HCIELab/EIT-kit_open-source/EIT-kit-Arduino-library/MCP23S17-modified-for-eit-kit/README.md

MCP23S17
========

Arduino library for MCP23S17 IO Expanders
