HCIELab/EIT-kit_open-source/EIT-kit-Board/ESP32_EIT_V3_fusion/ESP32_EIT_back.png

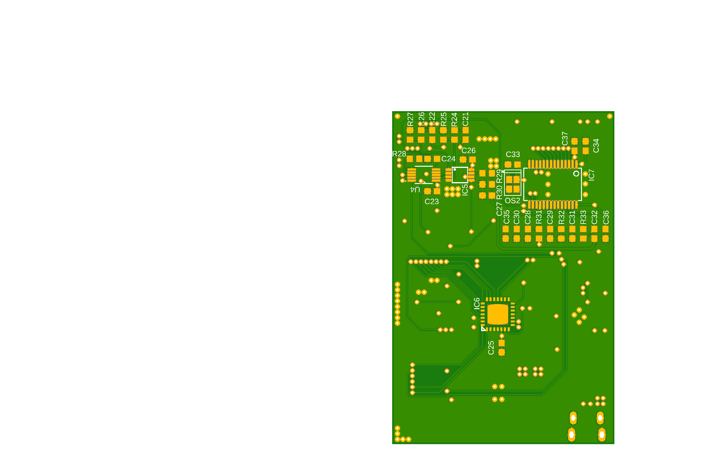
EIT-kit-Board/ESP32_EIT_V3_fusion/ESP32_EIT_back.png
