HCIELab/EIT-kit_open-source/EIT-kit-Board/ESP32_EIT_V3_fusion/ESP32_EIT_front.png

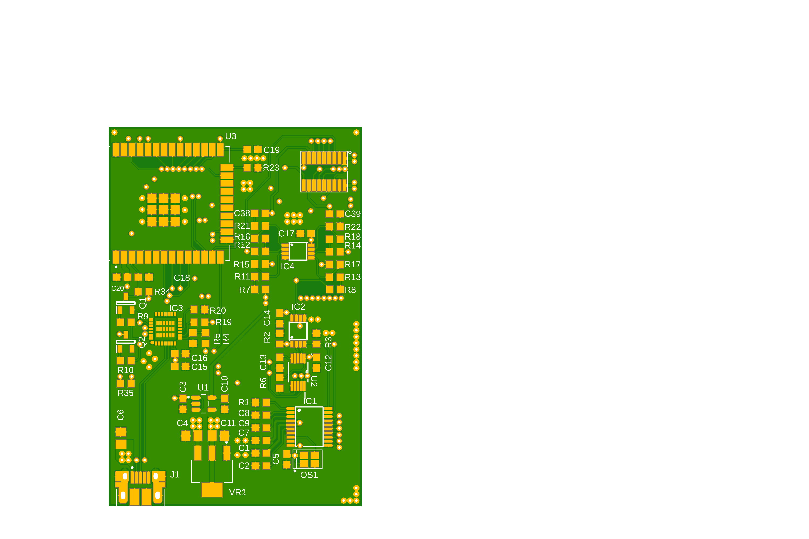
EIT-kit-Board/ESP32_EIT_V3_fusion/ESP32_EIT_front.png
