HCIELab/EIT-kit_open-source/EIT-kit-Board_new/Teensy_EIT_board-files/Main/PCB_bottom.png

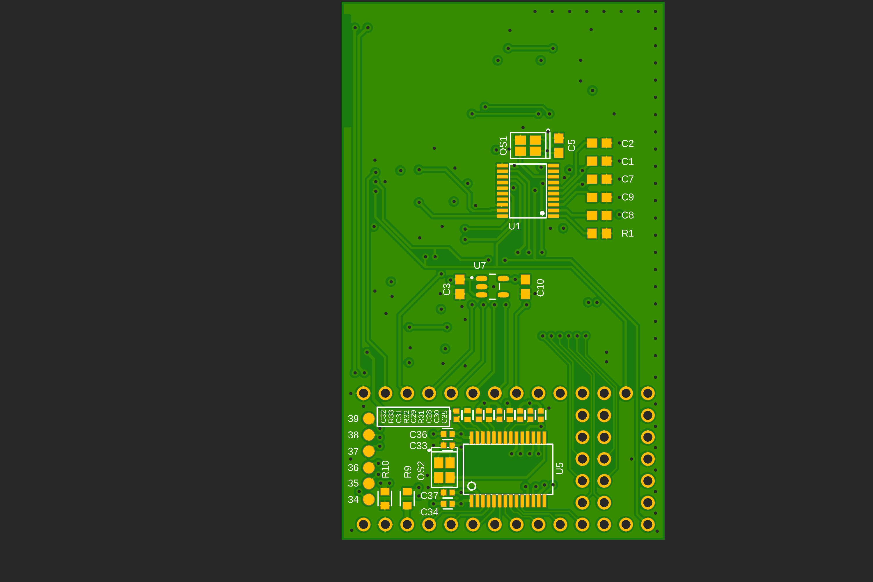
EIT-kit-Board_new/Teensy_EIT_board-files/Main/PCB_bottom.png
