HCIELab/EIT-kit_open-source/EIT-kit-Board_new/Teensy_EIT_board-files/MUX1/PCB_bottom.png

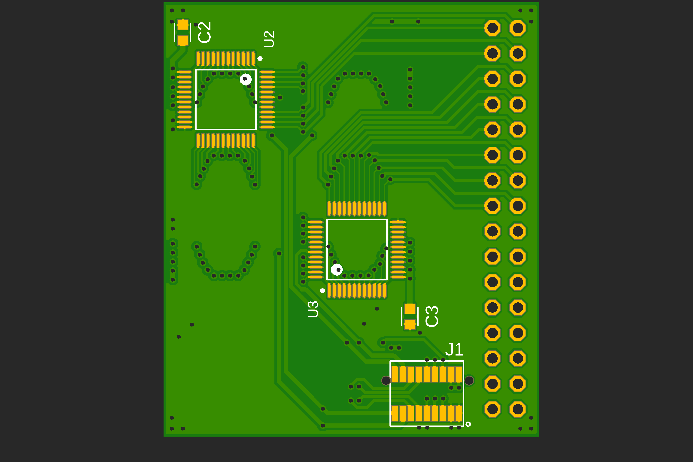
EIT-kit-Board_new/Teensy_EIT_board-files/MUX1/PCB_bottom.png
