HCIELab/EIT-kit_open-source/EIT-kit-Board_new/Teensy_EIT_board-files/MUX2/PCB_top.png

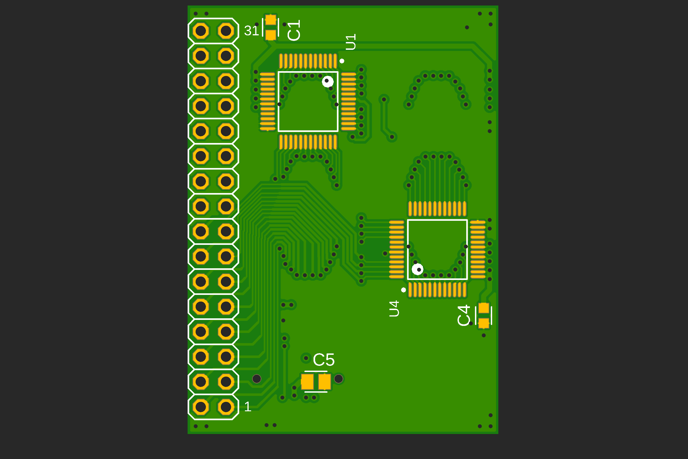
EIT-kit-Board_new/Teensy_EIT_board-files/MUX2/PCB_top.png
