HCIELab/EIT-kit_open-source/(threads)

Thread 1 (2022-05-18):

Mux board problem

MilesLeeee, 2022-05-18:
Hi ~
I would like to implement the sensing board in this paper, however ,I can not find the code of Mux board(ADG731), if possible, can I ask you for the Sorce code for this board?
thank you

MilesLeeee, 2022-05-30:
I'm an student from NCKU, our lab wants to implement an EIT device to measure the impedance changes in body muscle during exercise, so I want to try to implement this board and I hope to get your help if possible.
Sincerely,
MilesLeee

MilesLeeee, 2022-06-03:
Hello
I have a question about mux board and want to ask. There are two boards mux1 and mux2 in the file (the two boards seem to be different), we want to know whether the mux board mentioned in the paper uses mux1 or mux2? Is there a circuit or a BOM that we can refer to?thank you~
Sincerely,
MilesLeee

junyi7, 2022-06-06:
Hi MilesLeee,
The mux1 & mux2 are equivalent and can work individually or together, depends on how many electrodes you need for you application. Each mux board can support 32 electrodes. The BOM files for mux1 & mux2 are now in the git repo, they pretty much use the same components.
Let me know your email address if you want to try out the newer version, I can email the files to you :)
Best,
Junyi

MilesLeeee, 2022-08-10:
Hi Junyi~
I have some questions about the mux board, can you help me,thank you.
When we were doing it, we found that the part number in the MUX1_gerber file doesn't seem to match the part number in the Bom file (bom_mux_lower), can you help me see if there is something wrong?thank you
Here is my mail address : N26101800@gs.ncku.edu.tw, I hope I can contact you if I have other questions :)
Sincerely,
MilesLeee

Thread 6 (2023-01-11):

Cannot open Teensy board files in EAGLE

roy-zahor, 2023-01-11:
Hi,

New verison files in [EIT-kit-Board_new](https://github.com/HCIELab/EIT-kit_open-source/tree/main/EIT-kit-Board_new)
cannot be open in eagle. Both schematic and PCB files give warnings and files are partially opened. I can open the ESP32 files without a problem.

1. Is the Teensy version stable in terms of hardware & software or do you recommend using the ESP32 version?
2. Can you please check the files?

Many thanks,
Roy

junyi7, 2024-02-25:
Hi Roy,

Sorry for the confusion! Please try using Fusion 360 to open the new files rather than EAGLE, we switched the new files to Fusion 360 because EAGLE is discontinued and no longer supported by Autodesk, and they promotes everything to Fusion 360 instead. And yes, the Teensy version is more stable in terms of the hardware (more stable GPIO pin readings at high speed).

Best,
Junyi

Closed 2024-02-25.

Thread 7 (2025-07-29):

Help with building the board

emmapead, 2025-07-29:
Hello,

Thank you for sharing your fantastic work! I am a researcher in data science looking to use EIT for a project. I don't have the access to the expertise to develop the board myself and was looking into PCBway to assemble for me. I need some help with which files to send them.

Could you please advise?

Thank you :)
