HCIELab/EIT-kit_open-source/EIT-kit-Board_new/Teensy_EIT_board-files/Main/Schematic.pdf

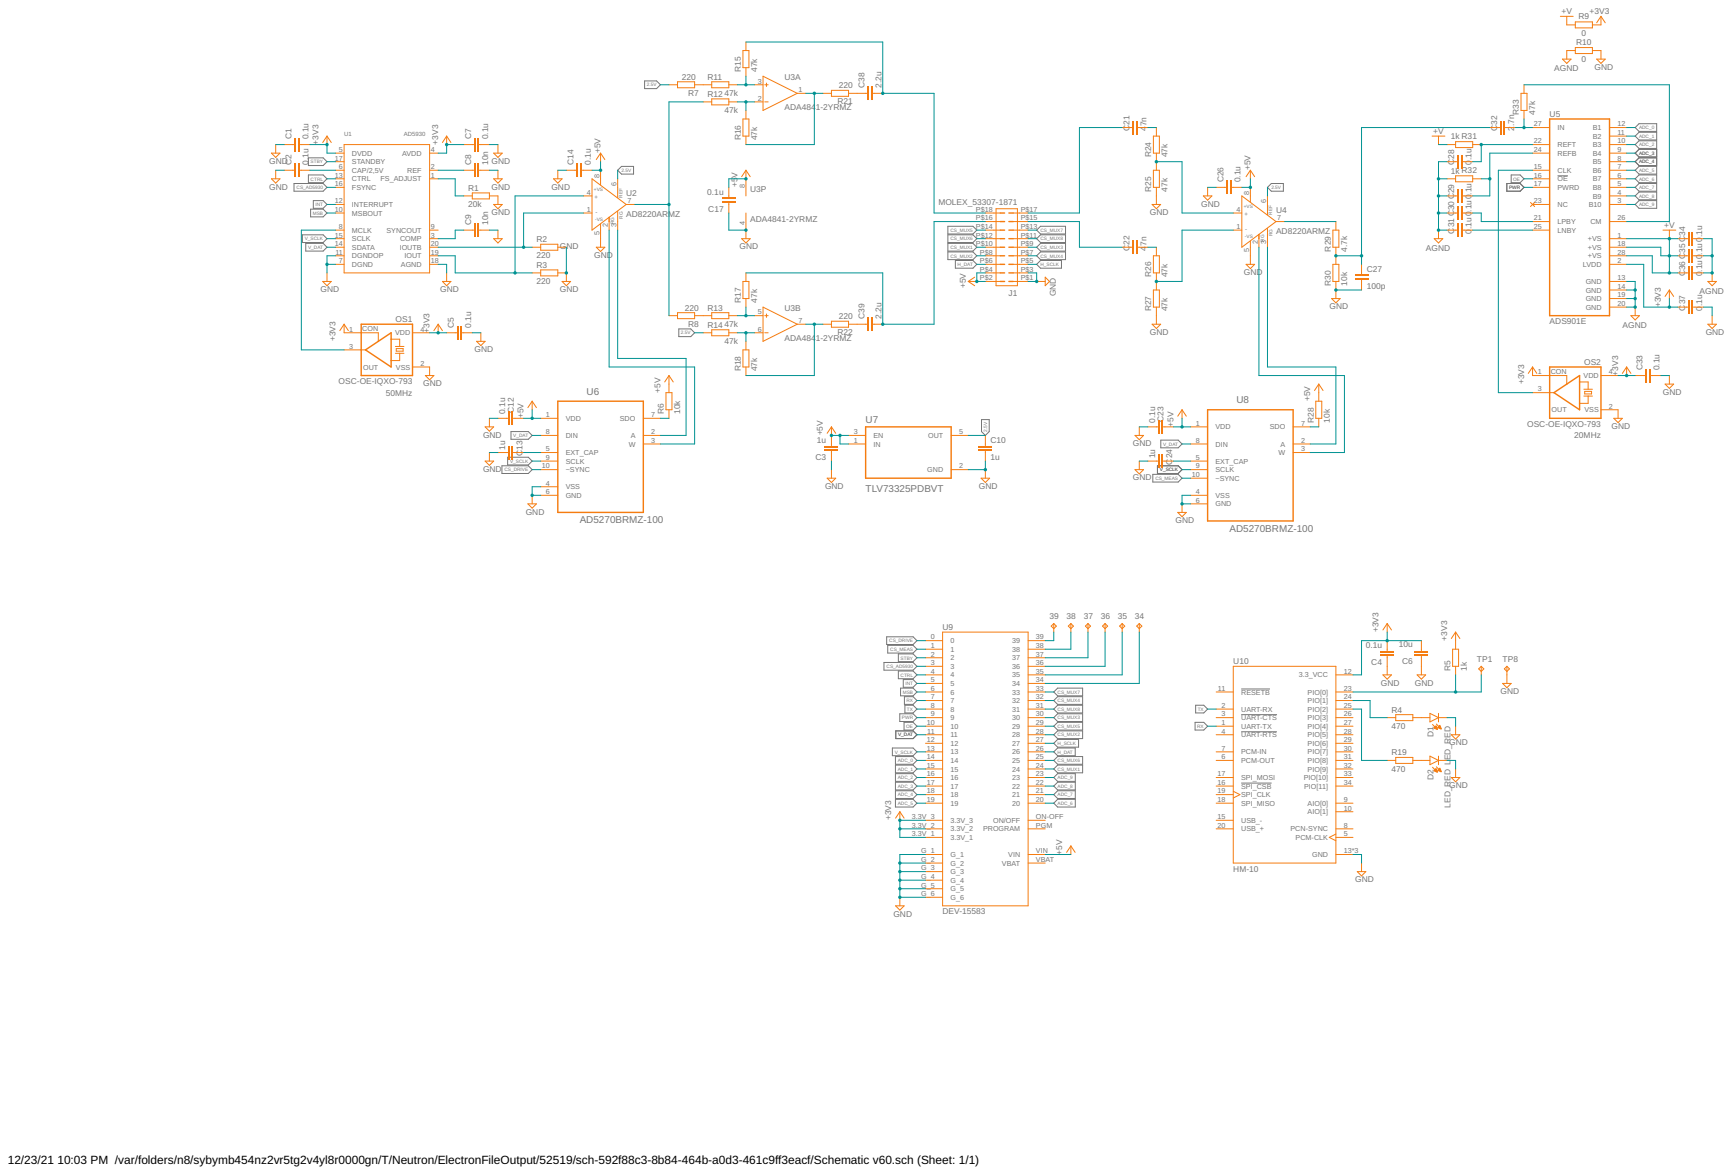
[picture p9: page 1]

12/23/21 10:03 PM /var/folders/n8/sybymb454nz2vr5tg2v4yl8r0000gn/T/Neutron/ElectronFileOutput/52519/sch-592f88c3-8b84-464b-a0d3-461c9ff3eacf/Schematic v60.sch (Sheet: 1/1)
