HCIELab/EIT-kit_open-source/EIT-kit-Board_new/Teensy_EIT_board-files/MUX1/Schematic.pdf

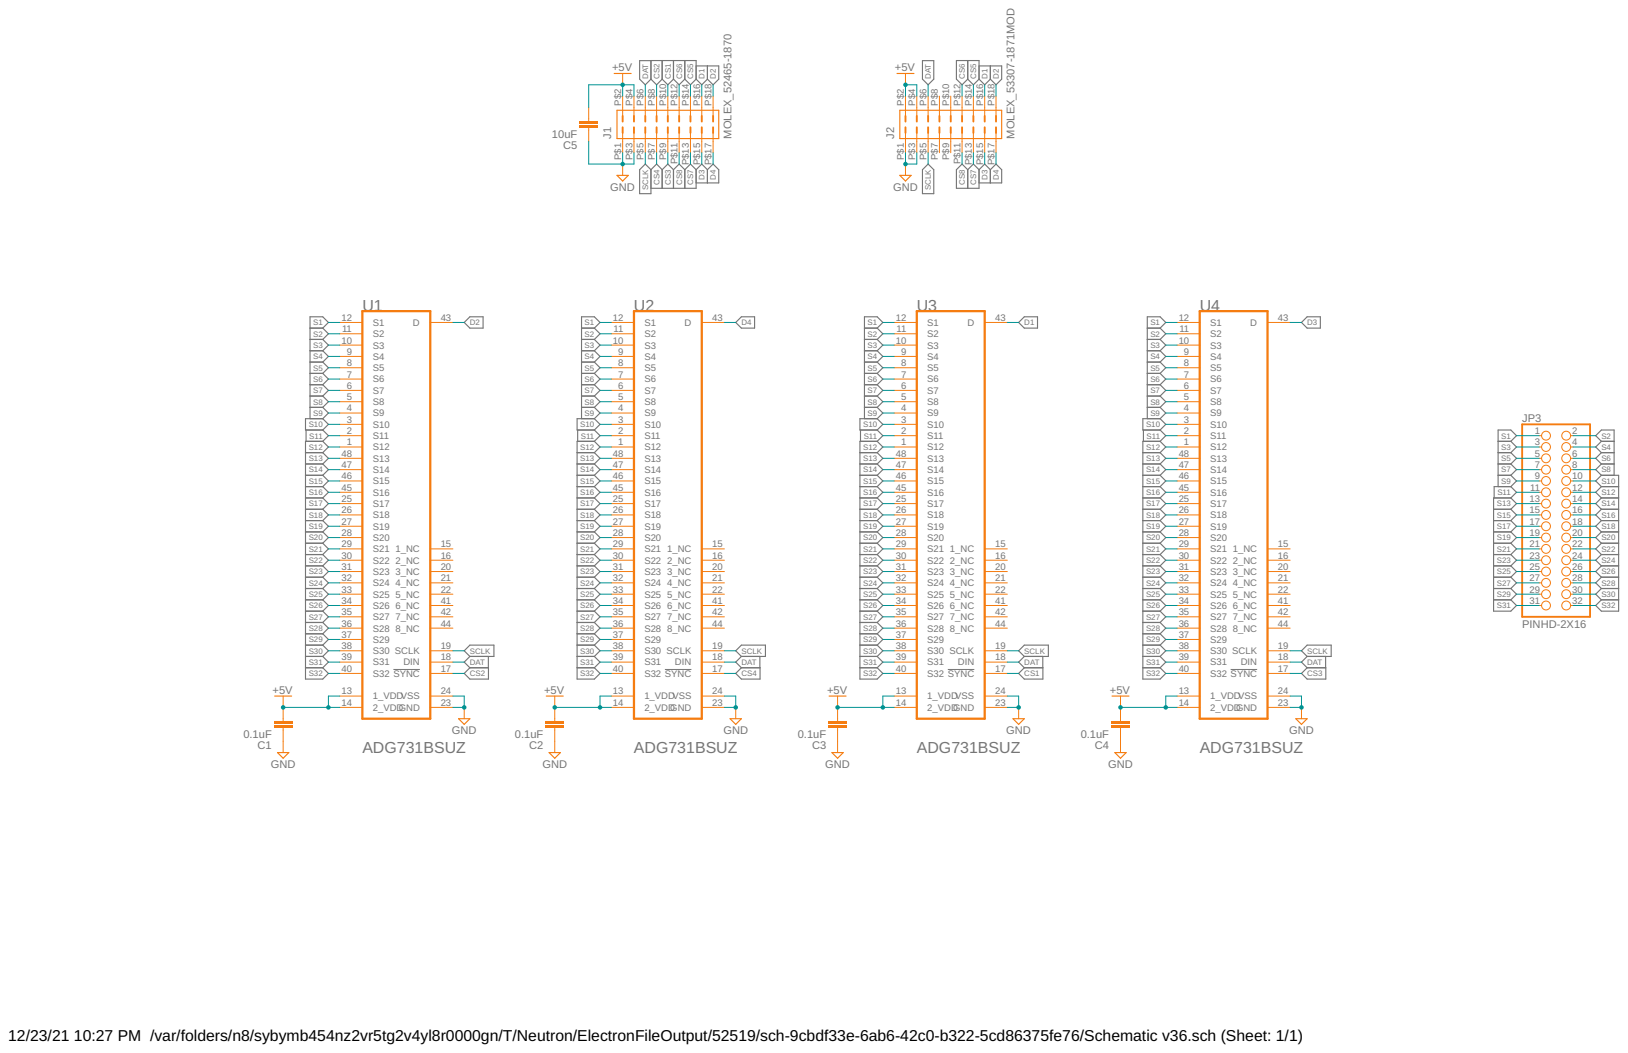
[picture p10: page 1]

12/23/21 10:27 PM /var/folders/n8/sybymb454nz2vr5tg2v4yl8r0000gn/T/Neutron/ElectronFileOutput/52519/sch-9cbdf33e-6ab6-42c0-b322-5cd86375fe76/Schematic v36.sch (Sheet: 1/1)
