HCIELab/EIT-kit_open-source/EIT-kit-Board_new/Teensy_EIT_board-files/MUX2/Schematic.pdf

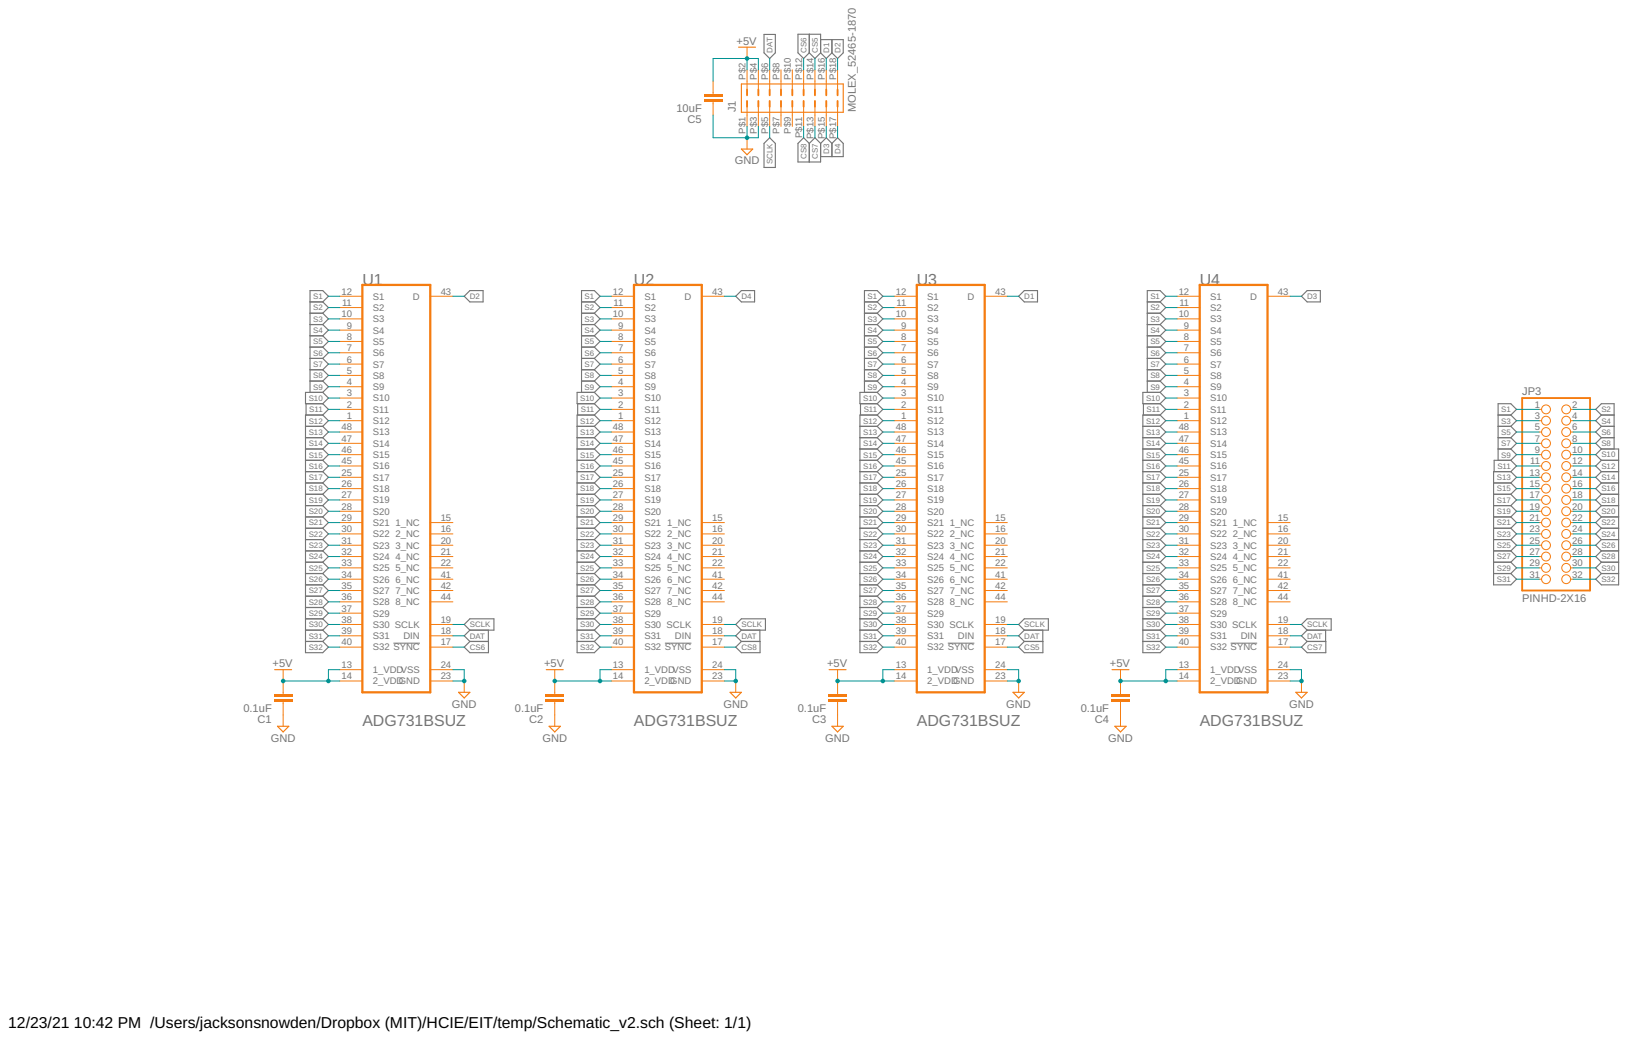
[picture p11: page 1]

12/23/21 10:42 PM /Users/jacksonsnowden/Dropbox (MIT)/HCIE/EIT/temp/Schematic_v2.sch (Sheet: 1/1)
