HCIELab/EIT-kit_open-source/EIT-kit-Board/ESP32_EIT_V3_fusion/Schematic/ESP32_EIT.pdf

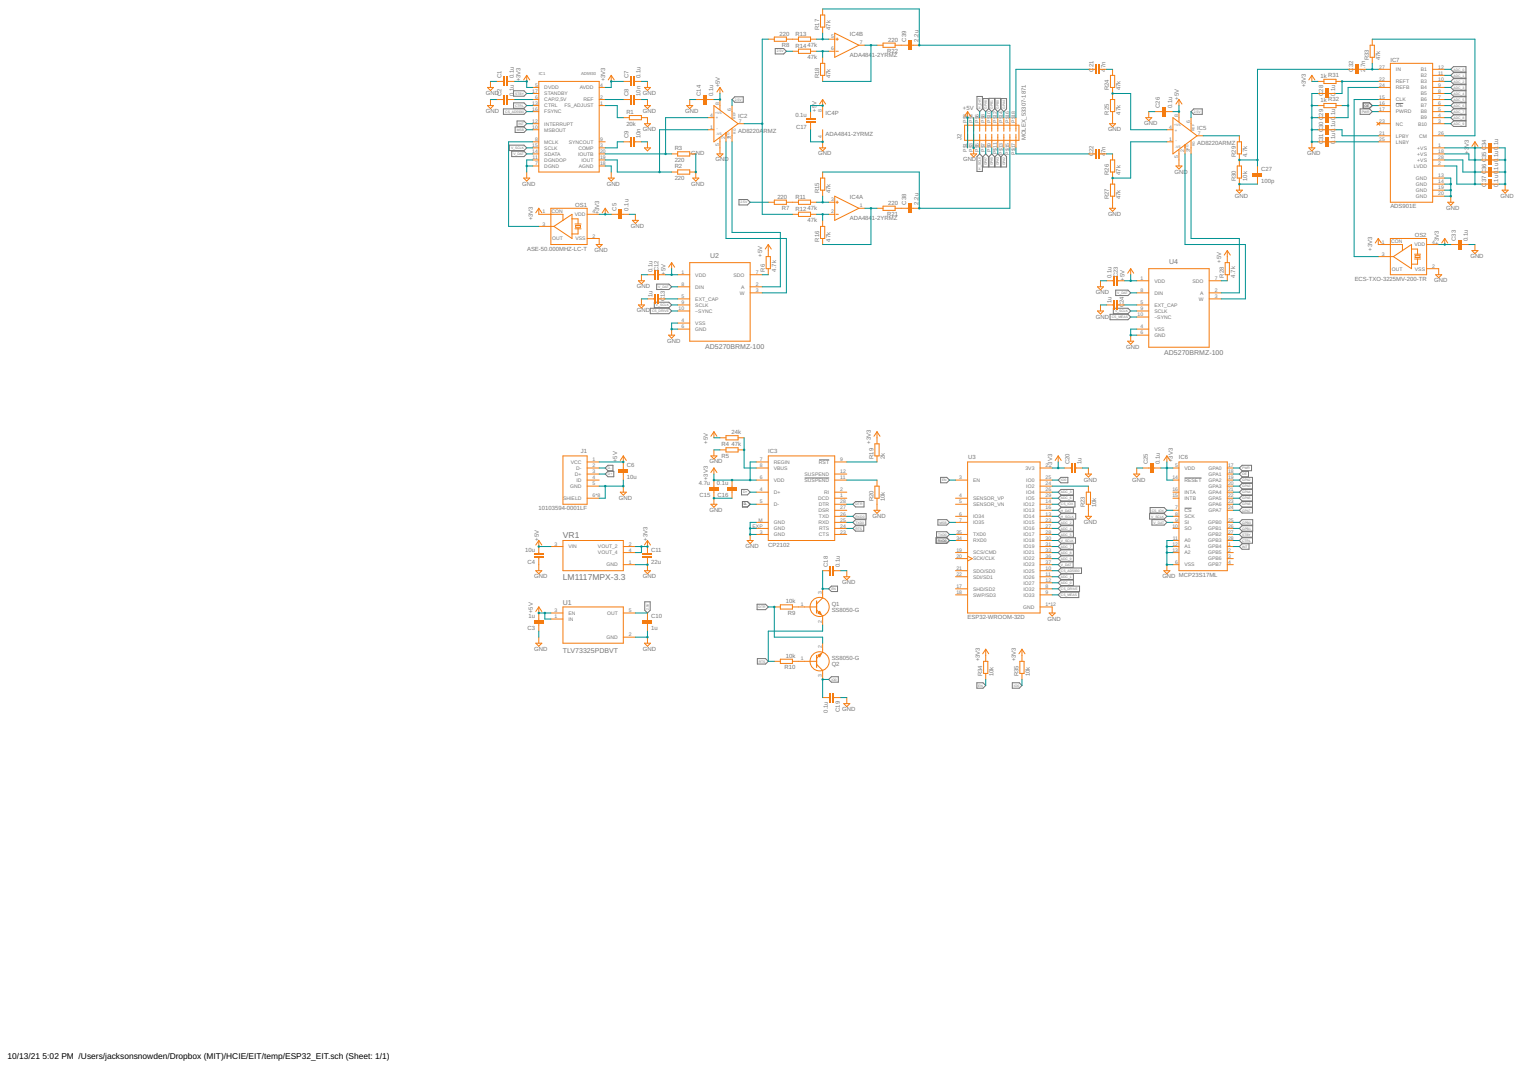
[picture p12: page 1]

10/13/21 5:02 PM /Users/jacksonsnowden/Dropbox (MIT)/HCIE/EIT/temp/ESP32_EIT.sch (Sheet: 1/1)
