HCIELab/EIT-kit_open-source/EIT-kit-Board/ESP32_EIT_V3_EAGLE/ESP32_EIT_V3.brd

## EAGLE design EIT-kit-Board/ESP32_EIT_V3_EAGLE/ESP32_EIT_V3.brd (2021-10-15)

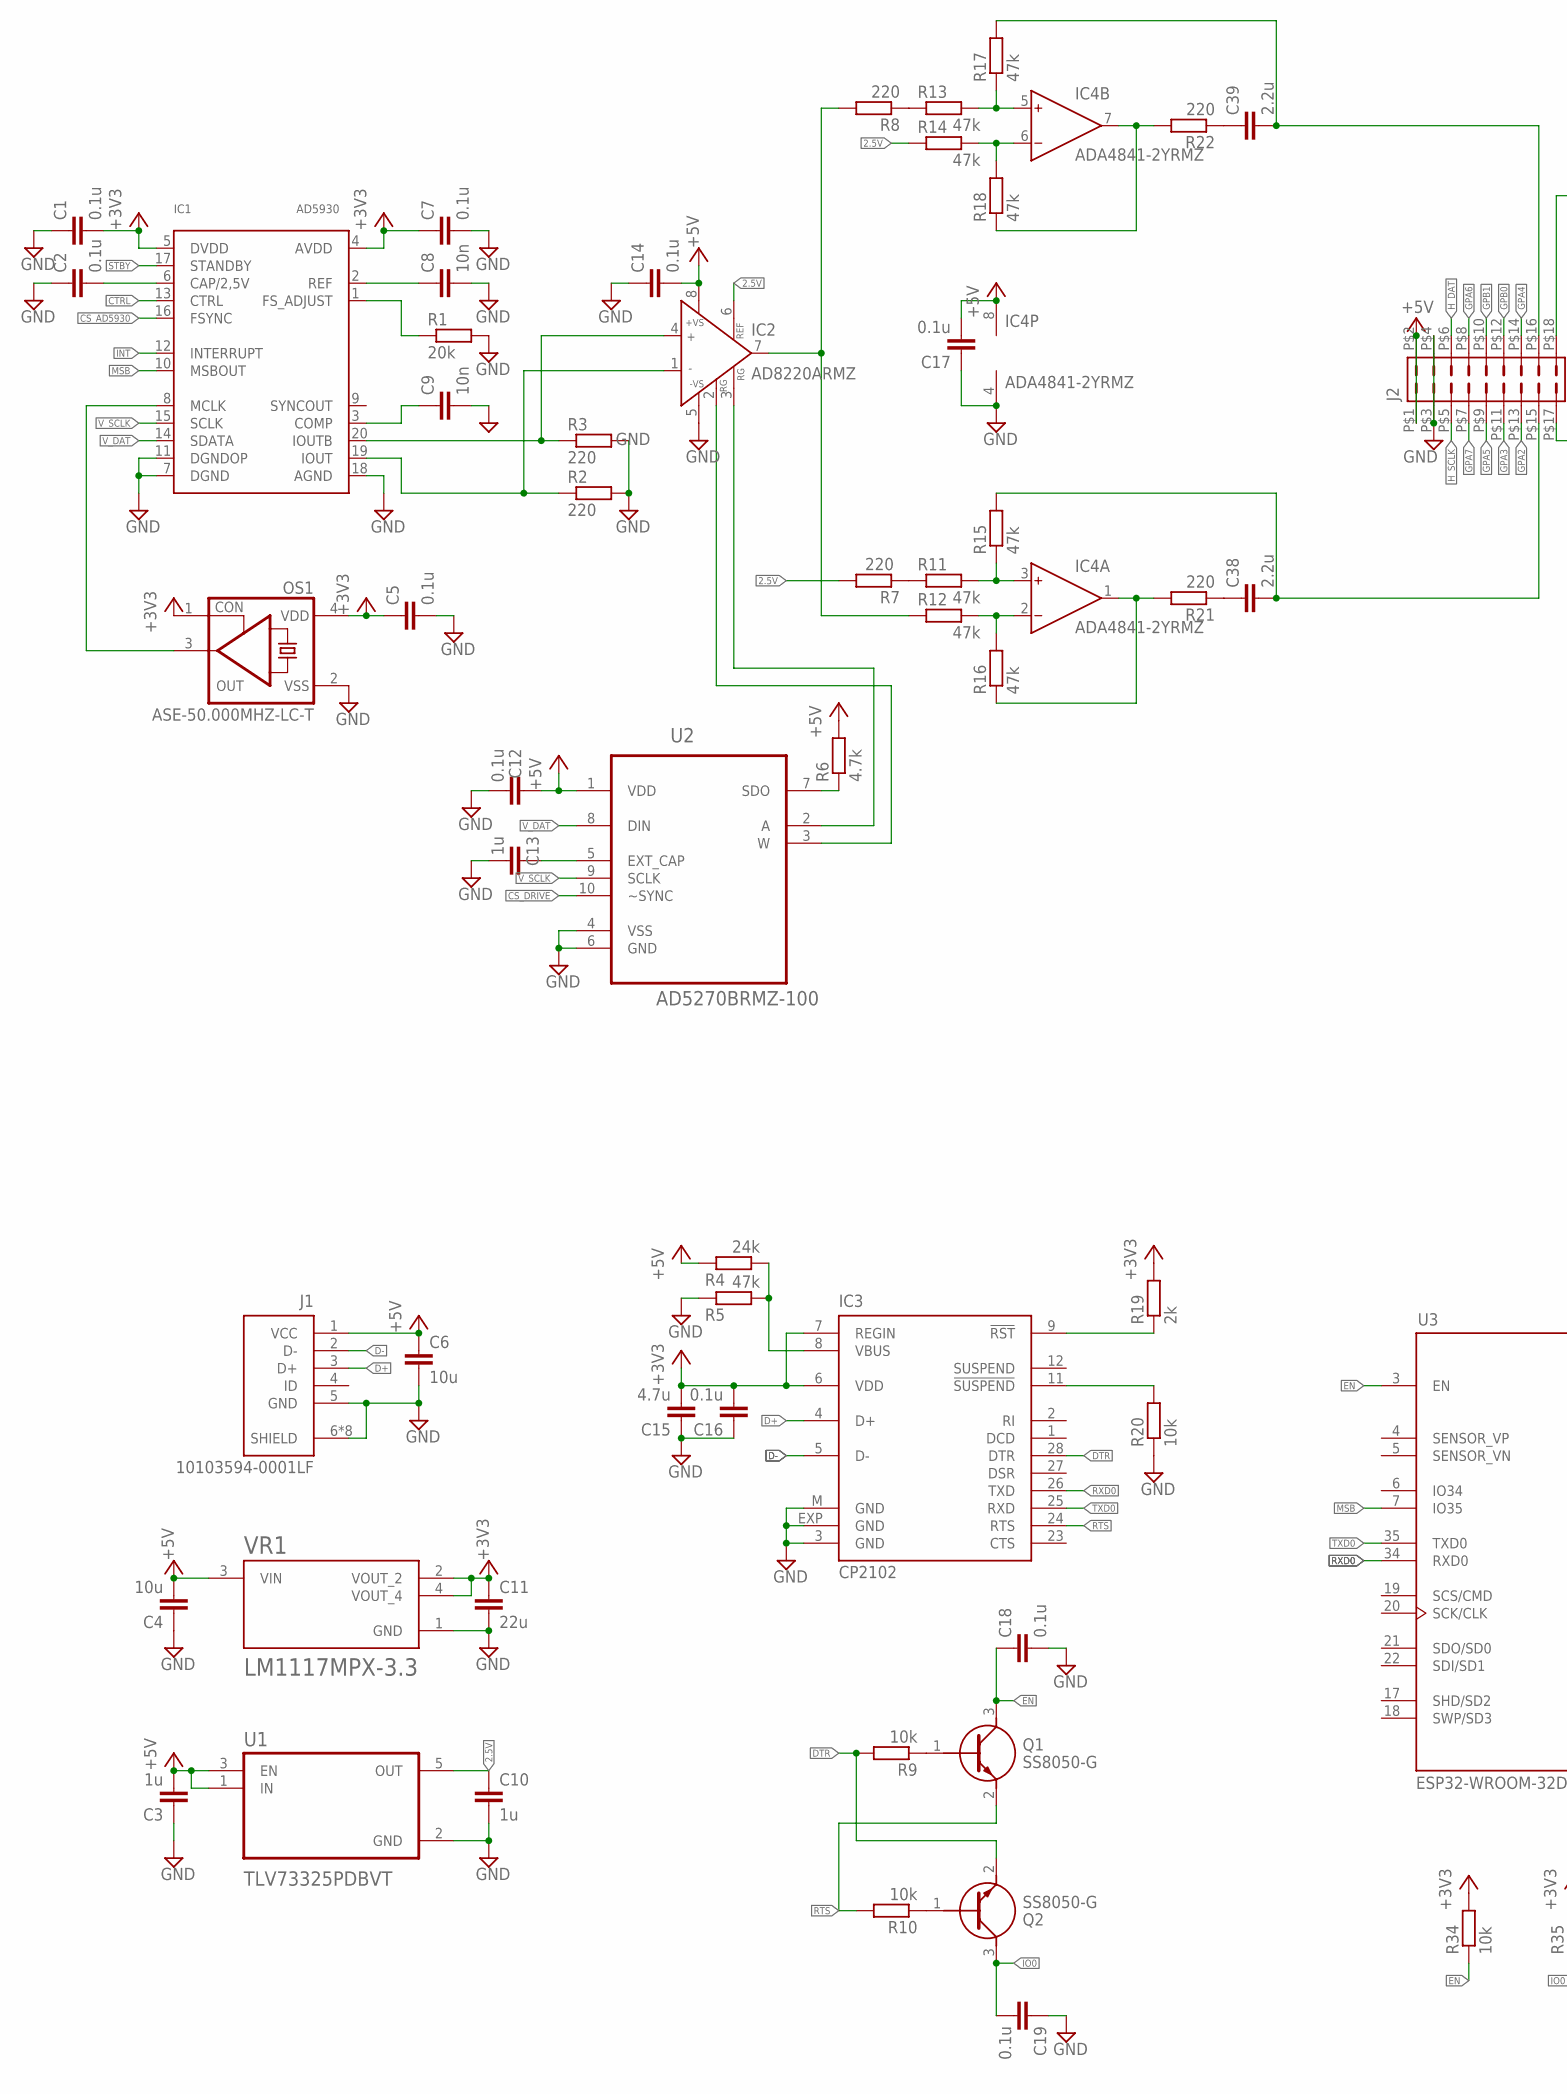
[picture p13: schematic ESP32_EIT_V3.sch, part in row 1, column 1]

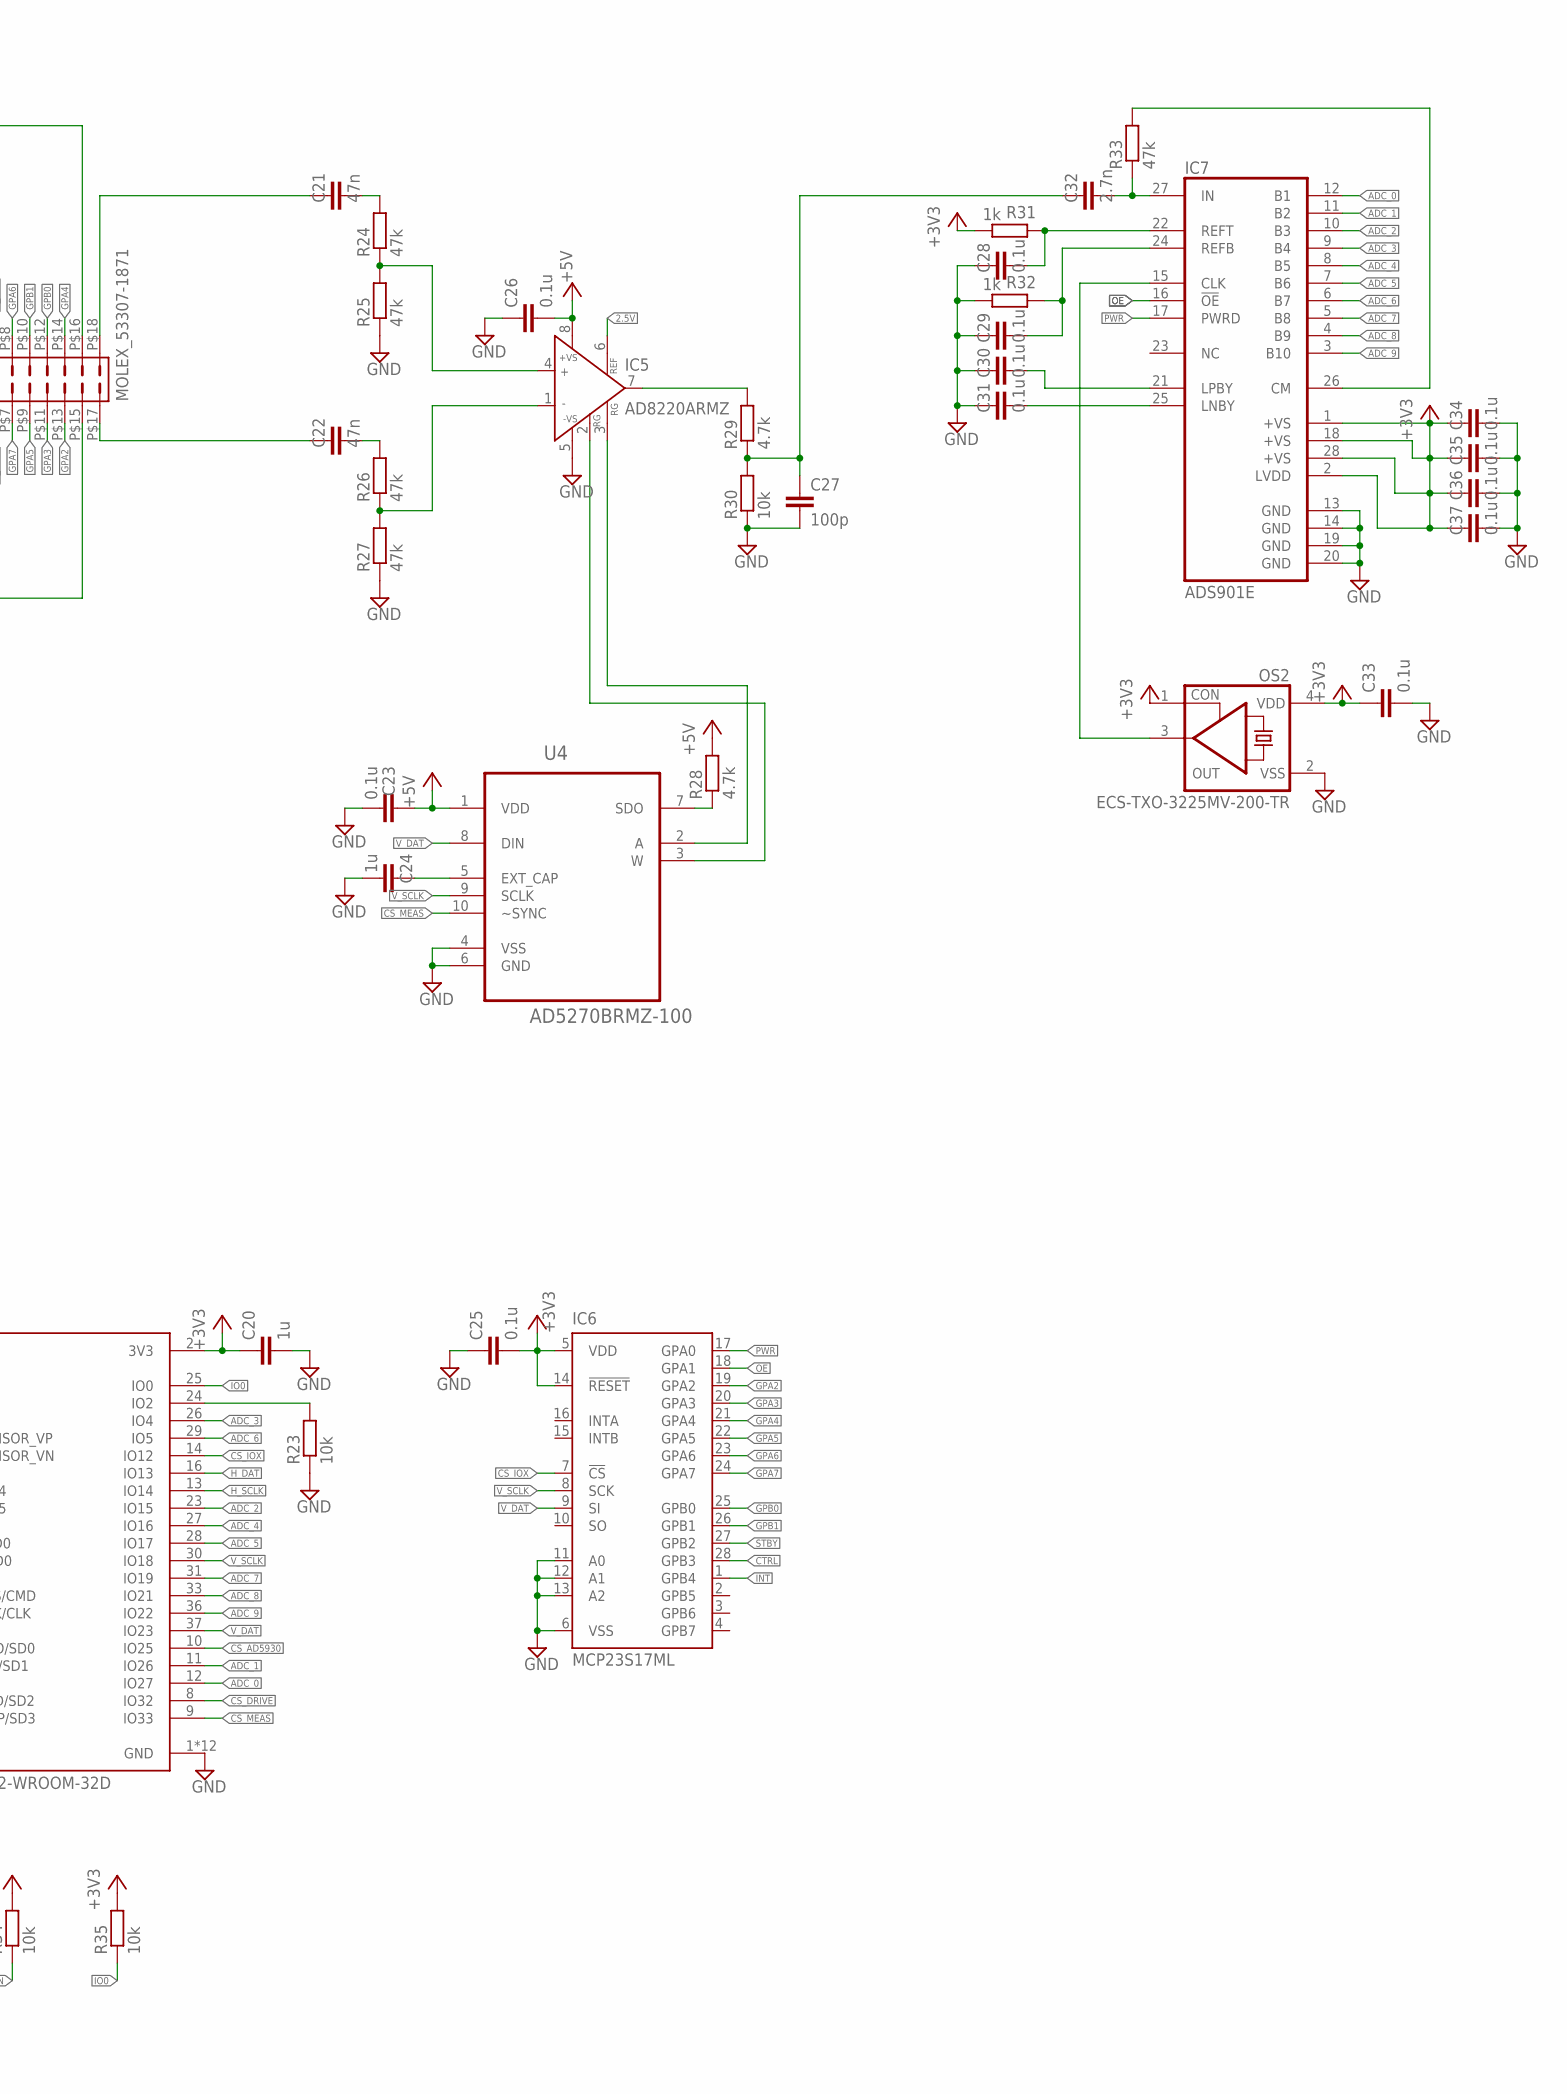
[picture p14: schematic ESP32_EIT_V3.sch, part in row 1, column 2]

Parts:
C1, C2, C5, C7, C12, C14, C16, C17, C18, C19, C23, C25, C26, C28, C29, C30, C31, C33, C34, C35, C36, C37: 0.1u; C0603
C3, C10, C13, C20, C24: 1u; C0603
C4, C6: 10u; C0805
C8, C9: 10n; C0603
C11: 22u; C0805
C15: 4.7u; C0603
C21, C22: 47n; C0603
C27: 100p; C0603
C32: 2.7n; C0603
C38, C39: 2.2u; C0603
IC1: AD5930; TSSOP20
IC2, IC5: AD8220ARMZ; MSOP8
IC3: CP2102; MLP28
IC4: ADA4841-2YRMZ; MSOP8
IC6: MCP23S17ML; QFN28-ML_6X6MM
IC7: ADS901E; SSOP28BU
J1: 10103594-0001LF; AMPHENOL_10103594-0001LF
J2: MOLEX_53307-1871
OS1: ASE-50.000MHZ-LC-T; 2.5X2-4-PAD
OS2: ECS-TXO-3225MV-200-TR; 2.5X2-4-PAD
Q1, Q2: SS8050-G; SOT95P240X115-3N
R1: 20k; R0603
R2, R3, R7, R8, R21, R22: 220; R0603
R4: 24k; R0603
R5, R11, R12, R13, R14, R15, R16, R17, R18, R24, R25, R26, R27, R33: 47k; R0603
R6, R28, R29: 4.7k; R0603
R9, R10, R20, R23, R30, R34, R35: 10k; R0603
R19: 2k; R0603
R31, R32: 1k; R0603
U1: TLV73325PDBVT; SOT95P280X145-5N
U2, U4: AD5270BRMZ-100; SOP50P490X110-10N
U3: ESP32-WROOM-32D; MODULE_ESP32-WROOM-32D
VR1: LM1117MPX-3.3; VREG_LM1117MPX-3.3

Connections:
2.5V: C10.1, IC2.6 (REF), IC5.6 (REF), R7.2, R14.1, U1.5 (OUT)
+3V3: C1.2, C5.1, C7.1, C11.1, C15.2, C16.2, C20.1, C25.2, C33.1, C34.1, C35.1, C36.1, C37.1, IC1.4 (AVDD), IC1.5 (DVDD), IC3.6 (VDD), IC3.7 (REGIN), IC6.5 (VDD), IC6.14 (!RESET), IC7.1 (+VS), IC7.2 (LVDD), IC7.18 (+VS), IC7.28 (+VS), OS1.1 (CON), OS1.4 (VDD), OS2.1 (CON), OS2.4 (VDD), R19.2, R31.2, R34.2, R35.2, U3.2 (3V3), VR1.2 (VOUT_2), VR1.4 (VOUT_4)
+5V: C3.2, C4.2, C6.1, C12.1, C14.2, C17.2, C23.1, C26.2, IC2.8 (+VS), IC4.8 (V+), IC5.8 (+VS), J1.1 (VCC), J2.P$1 (1), J2.P$2 (2), R4.2, R6.2, R28.2, U1.1 (IN), U1.3 (EN), U2.1 (VDD), U4.1 (VDD), VR1.3 (VIN)
ADC_0: IC7.12 (B1), U3.12 (IO27)
ADC_1: IC7.11 (B2), U3.11 (IO26)
ADC_2: IC7.10 (B3), U3.23 (IO15)
ADC_3: IC7.9 (B4), U3.26 (IO4)
ADC_4: IC7.8 (B5), U3.27 (IO16)
ADC_5: IC7.7 (B6), U3.28 (IO17)
ADC_6: IC7.6 (B7), U3.29 (IO5)
ADC_7: IC7.5 (B8), U3.31 (IO19)
ADC_8: IC7.4 (B9), U3.33 (IO21)
ADC_9: IC7.3 (B10), U3.36 (IO22)
CS_AD5930: IC1.16 (FSYNC), U3.10 (IO25)
CS_DRIVE: U2.10 (~SYNC), U3.8 (IO32)
CS_IOX: IC6.7 (!CS), U3.14 (IO12)
CS_MEAS: U3.9 (IO33), U4.10 (~SYNC)
CTRL: IC1.13 (CTRL), IC6.28 (GPB3)
D+: IC3.4 (D+), J1.3 (D+)
D-: IC3.5 (D-), J1.2 (D-)
DTR: IC3.28 (DTR), Q2.2 (E), R9.2
EN: C18.1, Q1.3 (C), R34.1, U3.3 (EN)
GND: C1.1, C2.1, C3.1, C4.1, C5.2, C6.2, C7.2, C8.2, C9.2, C10.2, C11.2, C12.2, C13.2, C14.1, C15.1, C16.1, C17.1, C18.2, C19.1, C20.2, C23.2, C24.2, C25.1, C26.1, C27.2, C28.1, C29.1, C30.1, C31.1, C33.2, C34.2, C35.2, C36.2, C37.2, IC1.7 (DGND), IC1.11 (DGNDOP), IC1.18 (AGND), IC2.5 (-VS), IC3.3 (GND), IC3.EXP (GND), IC3.M (GND), IC4.4 (V-), IC5.5 (-VS), IC6.6 (VSS), IC6.11 (A0), IC6.12 (A1), IC6.13 (A2), IC7.13 (GND), IC7.14 (GND), IC7.19 (GND), IC7.20 (GND), J1.5 (GND), J1.6 (SHIELD), J1.7 (SHIELD), J1.8 (SHIELD), J1.9 (SHIELD), J1.10 (SHIELD), J1.11 (SHIELD), J1.S1 (SHIELD), J1.S2 (SHIELD), J2.P$3 (3), J2.P$4 (4), OS1.2 (VSS), OS2.2 (VSS), R1.2, R2.2, R3.2, R5.2, R20.1, R23.1, R25.1, R27.1, R30.1, R32.2, U1.2 (GND), U2.4 (VSS), U2.6 (GND), U3.1 (GND), U3.15 (GND), U3.38 (GND), U3.39_1 (GND), U3.39_2 (GND), U3.39_3 (GND), U3.39_4 (GND), U3.39_5 (GND), U3.39_6 (GND), U3.39_7 (GND), U3.39_8 (GND), U3.39_9 (GND), U4.4 (VSS), U4.6 (GND), VR1.1 (GND)
GPA2: IC6.19 (GPA2), J2.P$13 (13)
GPA3: IC6.20 (GPA3), J2.P$11 (11)
GPA4: IC6.21 (GPA4), J2.P$14 (14)
GPA5: IC6.22 (GPA5), J2.P$9 (9)
GPA6: IC6.23 (GPA6), J2.P$8 (8)
GPA7: IC6.24 (GPA7), J2.P$7 (7)
GPB0: IC6.25 (GPB0), J2.P$12 (12)
GPB1: IC6.26 (GPB1), J2.P$10 (10)
H_DAT: J2.P$6 (6), U3.16 (IO13)
H_SCLK: J2.P$5 (5), U3.13 (IO14)
INT: IC1.12 (INTERRUPT), IC6.1 (GPB4)
IO0: C19.2, Q2.3 (C), R35.1, U3.25 (IO0)
MSB: IC1.10 (MSBOUT), U3.7 (IO35)
unnamed: IC1.1 (FS_ADJUST), R1.1
unnamed: C8.1, IC1.2 (REF)
unnamed: C9.1, IC1.3 (COMP)
unnamed: IC1.20 (IOUTB), IC2.4 (IN+), R3.1
unnamed: R7.1, R11.1
unnamed: R8.1, R13.1
unnamed: IC4.6 (IN-), R14.2, R18.2
unnamed: IC4.5 (IN+), R13.2, R17.1
unnamed: IC4.3 (IN+), R11.2, R15.1
unnamed: IC4.2 (IN-), R12.2, R16.2
unnamed: IC4.1 (OUT), R16.1, R21.2
unnamed: IC1.8 (MCLK), OS1.3 (OUT)
unnamed: C2.2, IC1.6 (CAP/2,5V)
unnamed: IC4.7 (OUT), R18.1, R22.2
unnamed: R6.1, U2.7 (SDO)
unnamed: IC1.19 (IOUT), IC2.1 (IN-), R2.1
unnamed: IC2.2 (RG), U2.3 (W)
unnamed: IC2.7 (OUT), R8.2, R12.1
unnamed: IC2.3 (RG), U2.2 (A)
unnamed: C13.1, U2.5 (EXT_CAP)
unnamed: R28.1, U4.7 (SDO)
unnamed: IC7.26 (CM), R33.2
unnamed: C32.2, IC7.27 (IN), R33.1
unnamed: C24.1, U4.5 (EXT_CAP)
unnamed: C28.2, IC7.22 (REFT), R31.1
unnamed: C29.2, IC7.24 (REFB), R32.1
unnamed: C31.2, IC7.25 (LNBY)
unnamed: C30.2, IC7.21 (LPBY)
unnamed: IC5.2 (RG), U4.3 (W)
unnamed: IC7.15 (CLK), OS2.3 (OUT)
unnamed: IC5.7 (OUT), R29.2
unnamed: C21.2, R24.2
unnamed: IC5.4 (IN+), R24.1, R25.2
unnamed: IC5.1 (IN-), R26.1, R27.2
unnamed: C22.2, R26.2
unnamed: IC5.3 (RG), U4.2 (A)
unnamed: C27.1, C32.1, R29.1, R30.2
unnamed: IC3.11 (!SUSPEND), R20.2
unnamed: IC3.8 (VBUS), R4.1, R5.1
unnamed: R23.2, U3.24 (IO2)
unnamed: IC3.9 (!RST), R19.1
unnamed: Q1.1 (B), R9.1
unnamed: Q2.1 (B), R10.1
unnamed: C21.1, J2.P$18 (18)
unnamed: C22.1, J2.P$17 (17)
unnamed: C38.2, J2.P$15 (15), R15.2
unnamed: C39.2, J2.P$16 (16), R17.2
unnamed: C38.1, R21.1
unnamed: C39.1, R22.1
OE: IC6.18 (GPA1), IC7.16 (!OE)
PWR: IC6.17 (GPA0), IC7.17 (PWRD)
RTS: IC3.24 (RTS), Q1.2 (E), R10.2
RXD0: IC3.26 (TXD), U3.34 (RXD0)
STBY: IC1.17 (STANDBY), IC6.27 (GPB2)
TXD0: IC3.25 (RXD), U3.35 (TXD0)
V_DAT: IC1.14 (SDATA), IC6.9 (SI), U2.8 (DIN), U3.37 (IO23), U4.8 (DIN)
V_SCLK: IC1.15 (SCLK), IC6.8 (SCK), U2.9 (SCLK), U3.30 (IO18), U4.9 (SCLK)

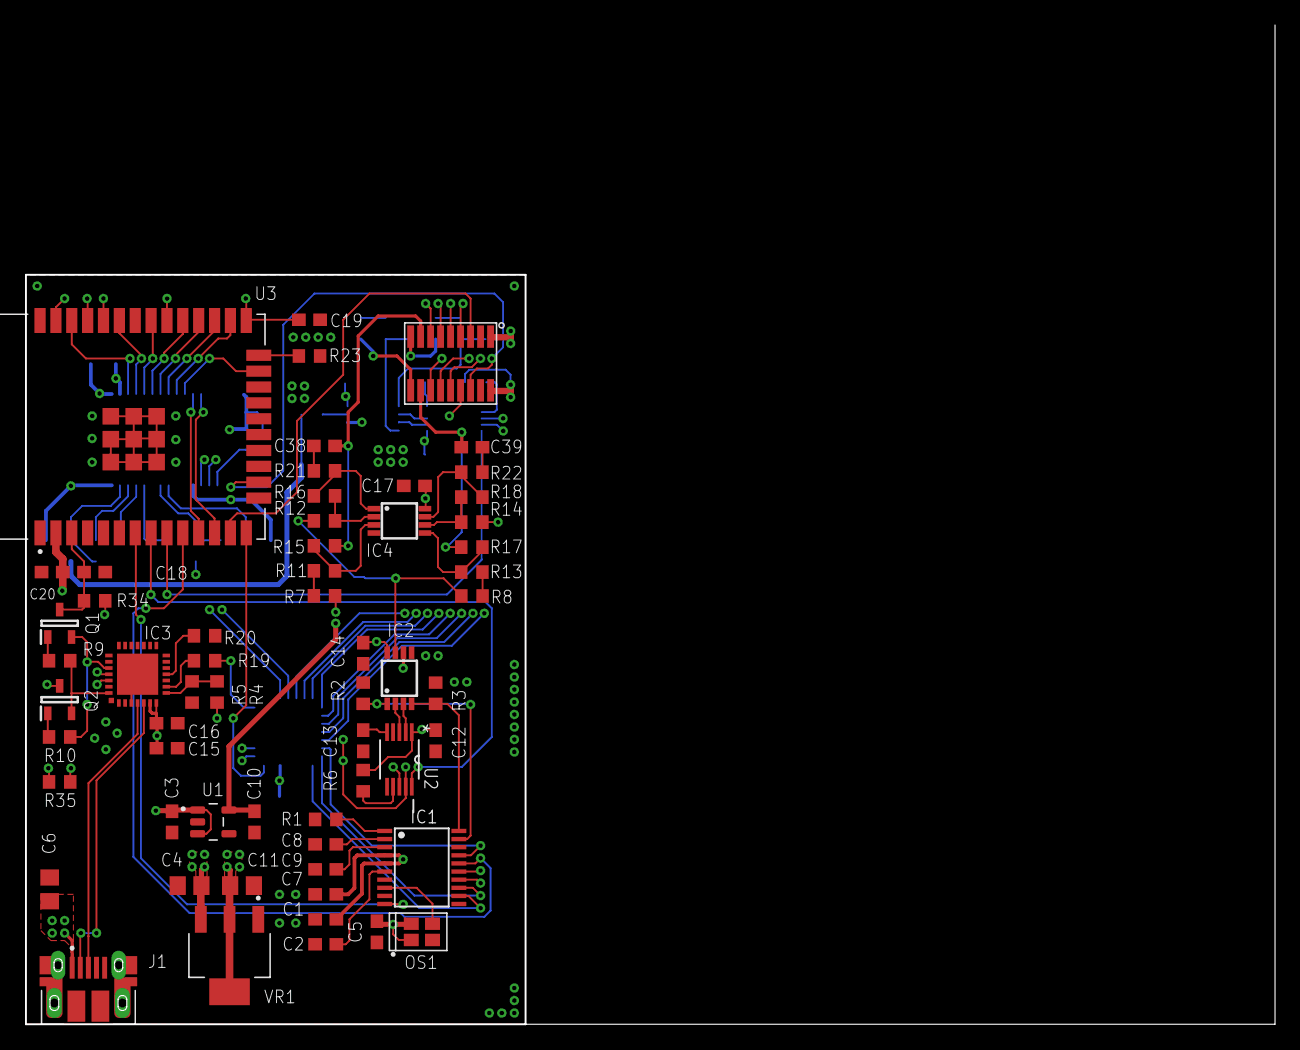
[picture p15: board ESP32_EIT_V3.brd from above]

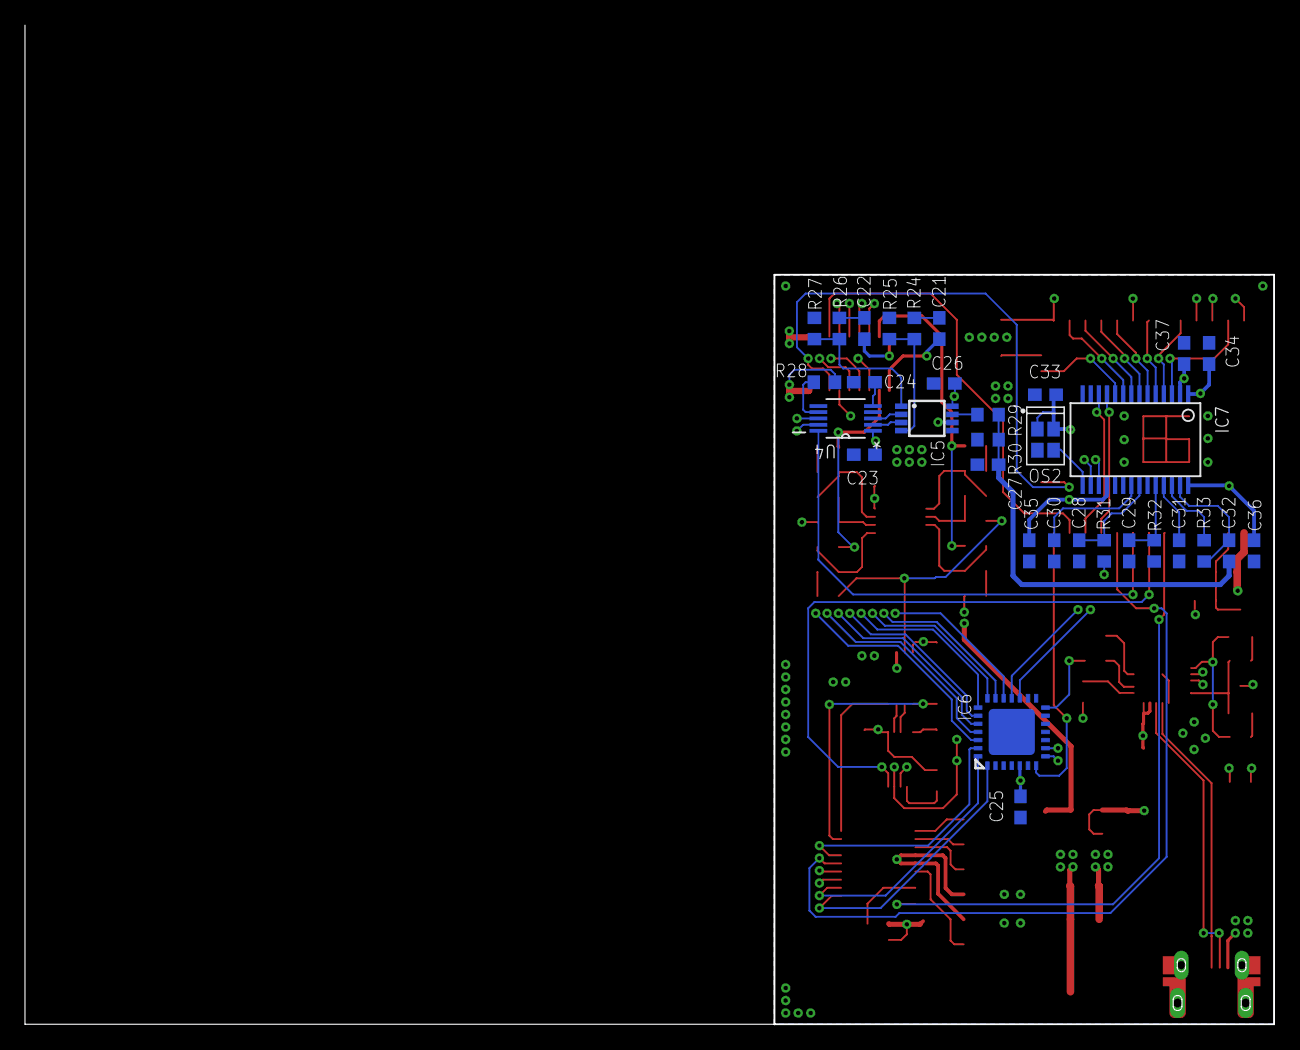
[picture p16: board ESP32_EIT_V3.brd from below]

Board: 4 copper layers, 40.0 x 60.0 mm, 92 parts (32 on the bottom side), 93 nets.
