HCIELab/EIT-kit_open-source/EIT-kit-Board_new/Teensy_EIT_board-files/Main/PCB.brd

## EAGLE design EIT-kit-Board_new/Teensy_EIT_board-files/Main/PCB.brd (2022-09-01)

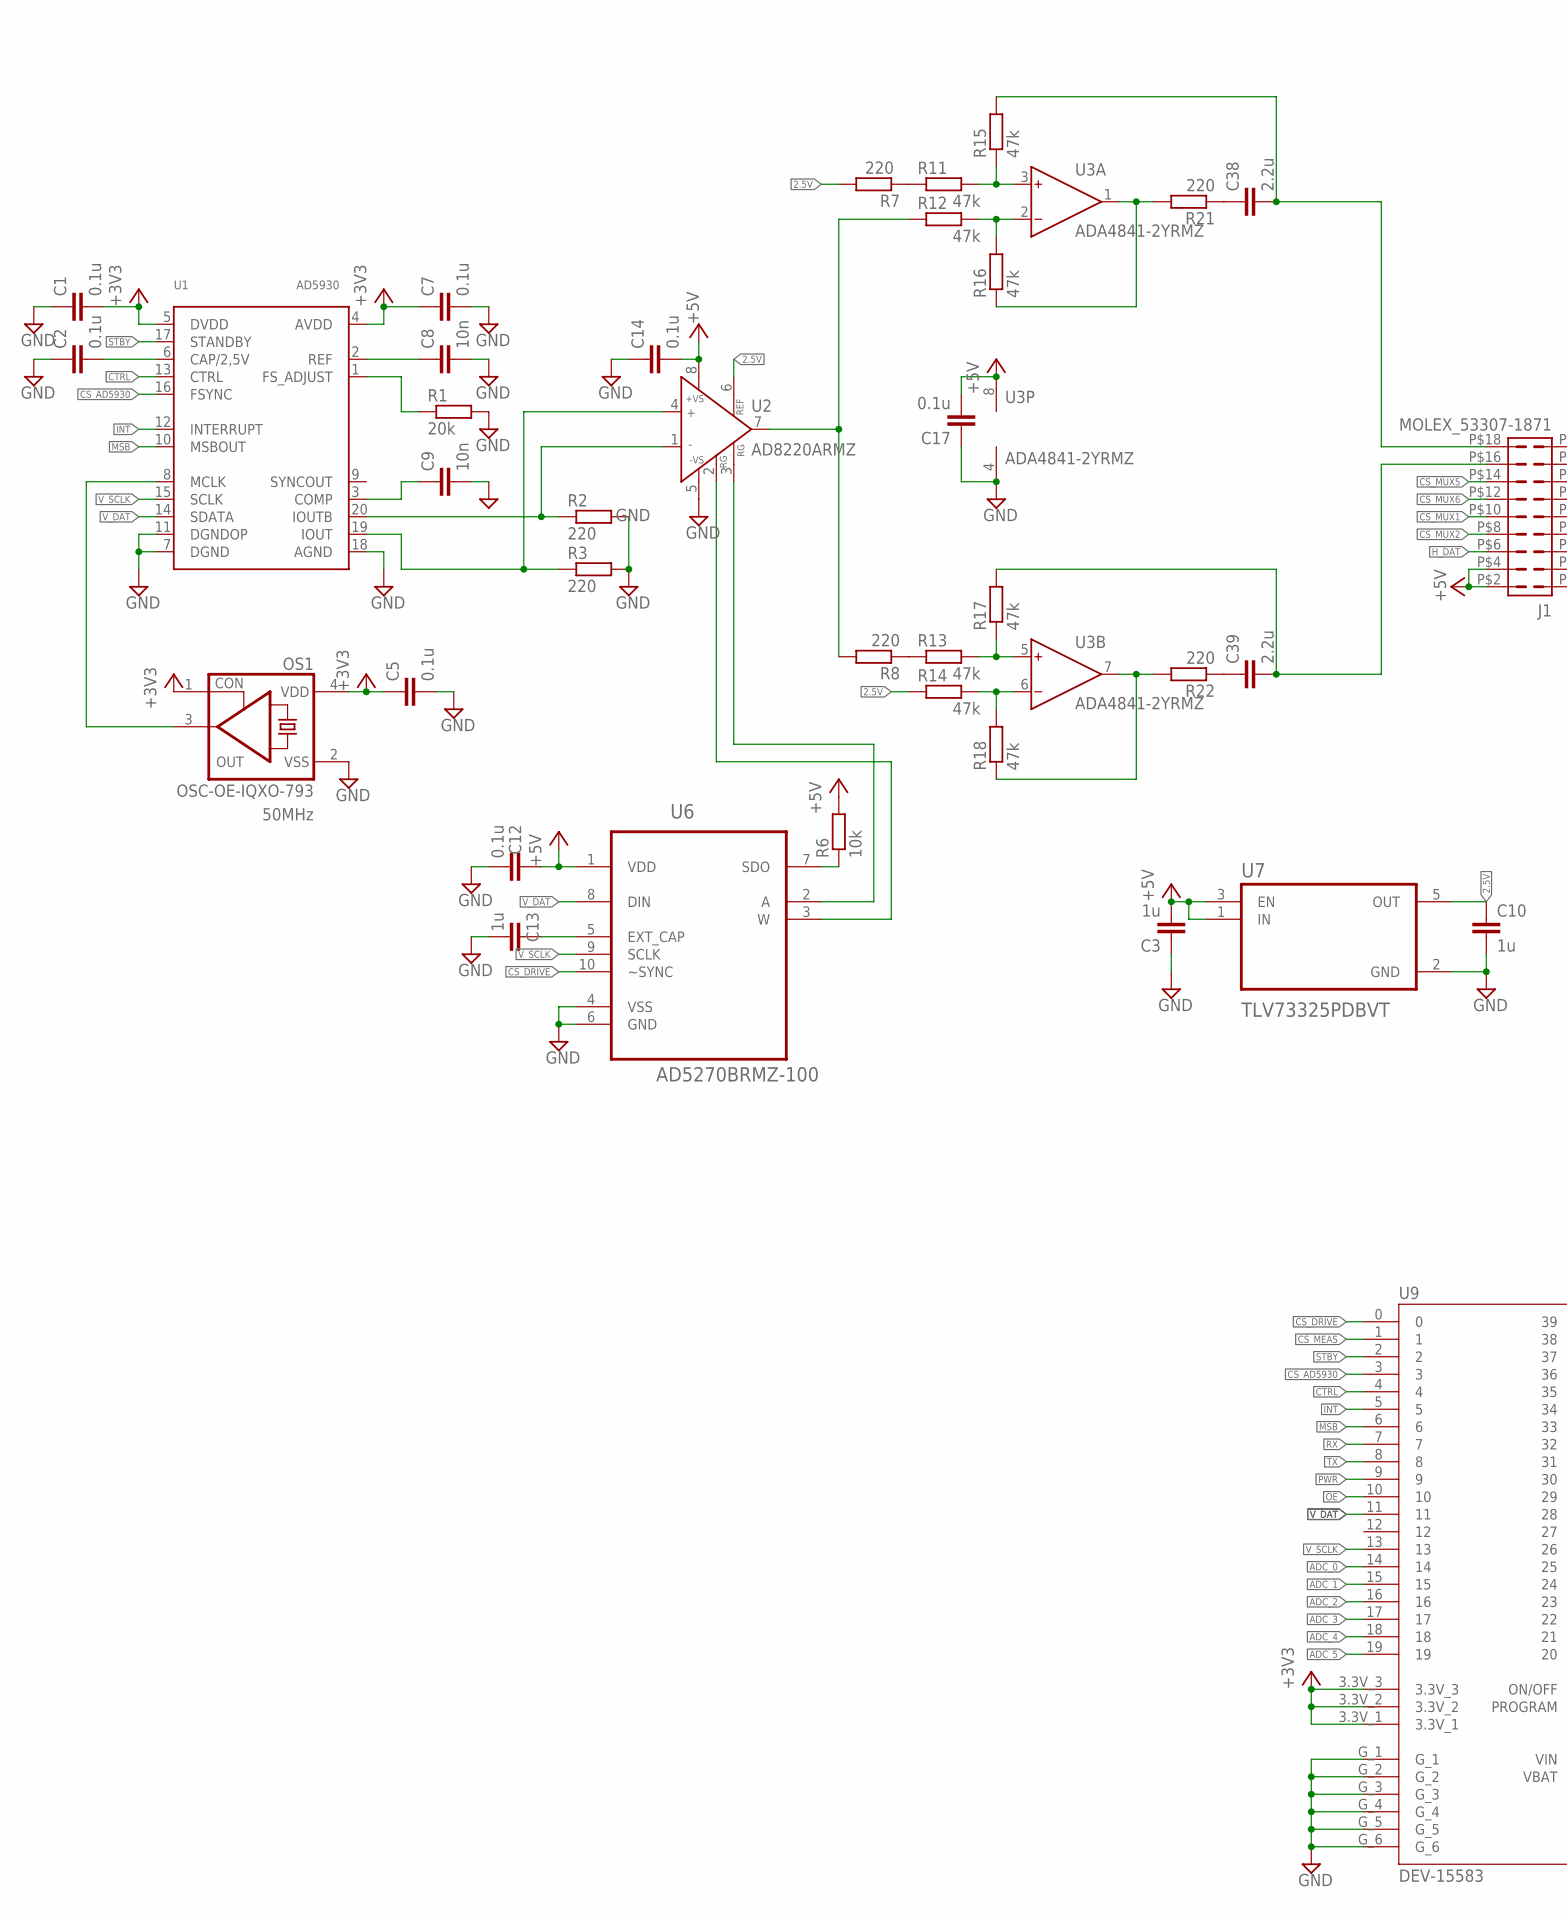
[picture p20: schematic Schematic.sch, part in row 1, column 1]

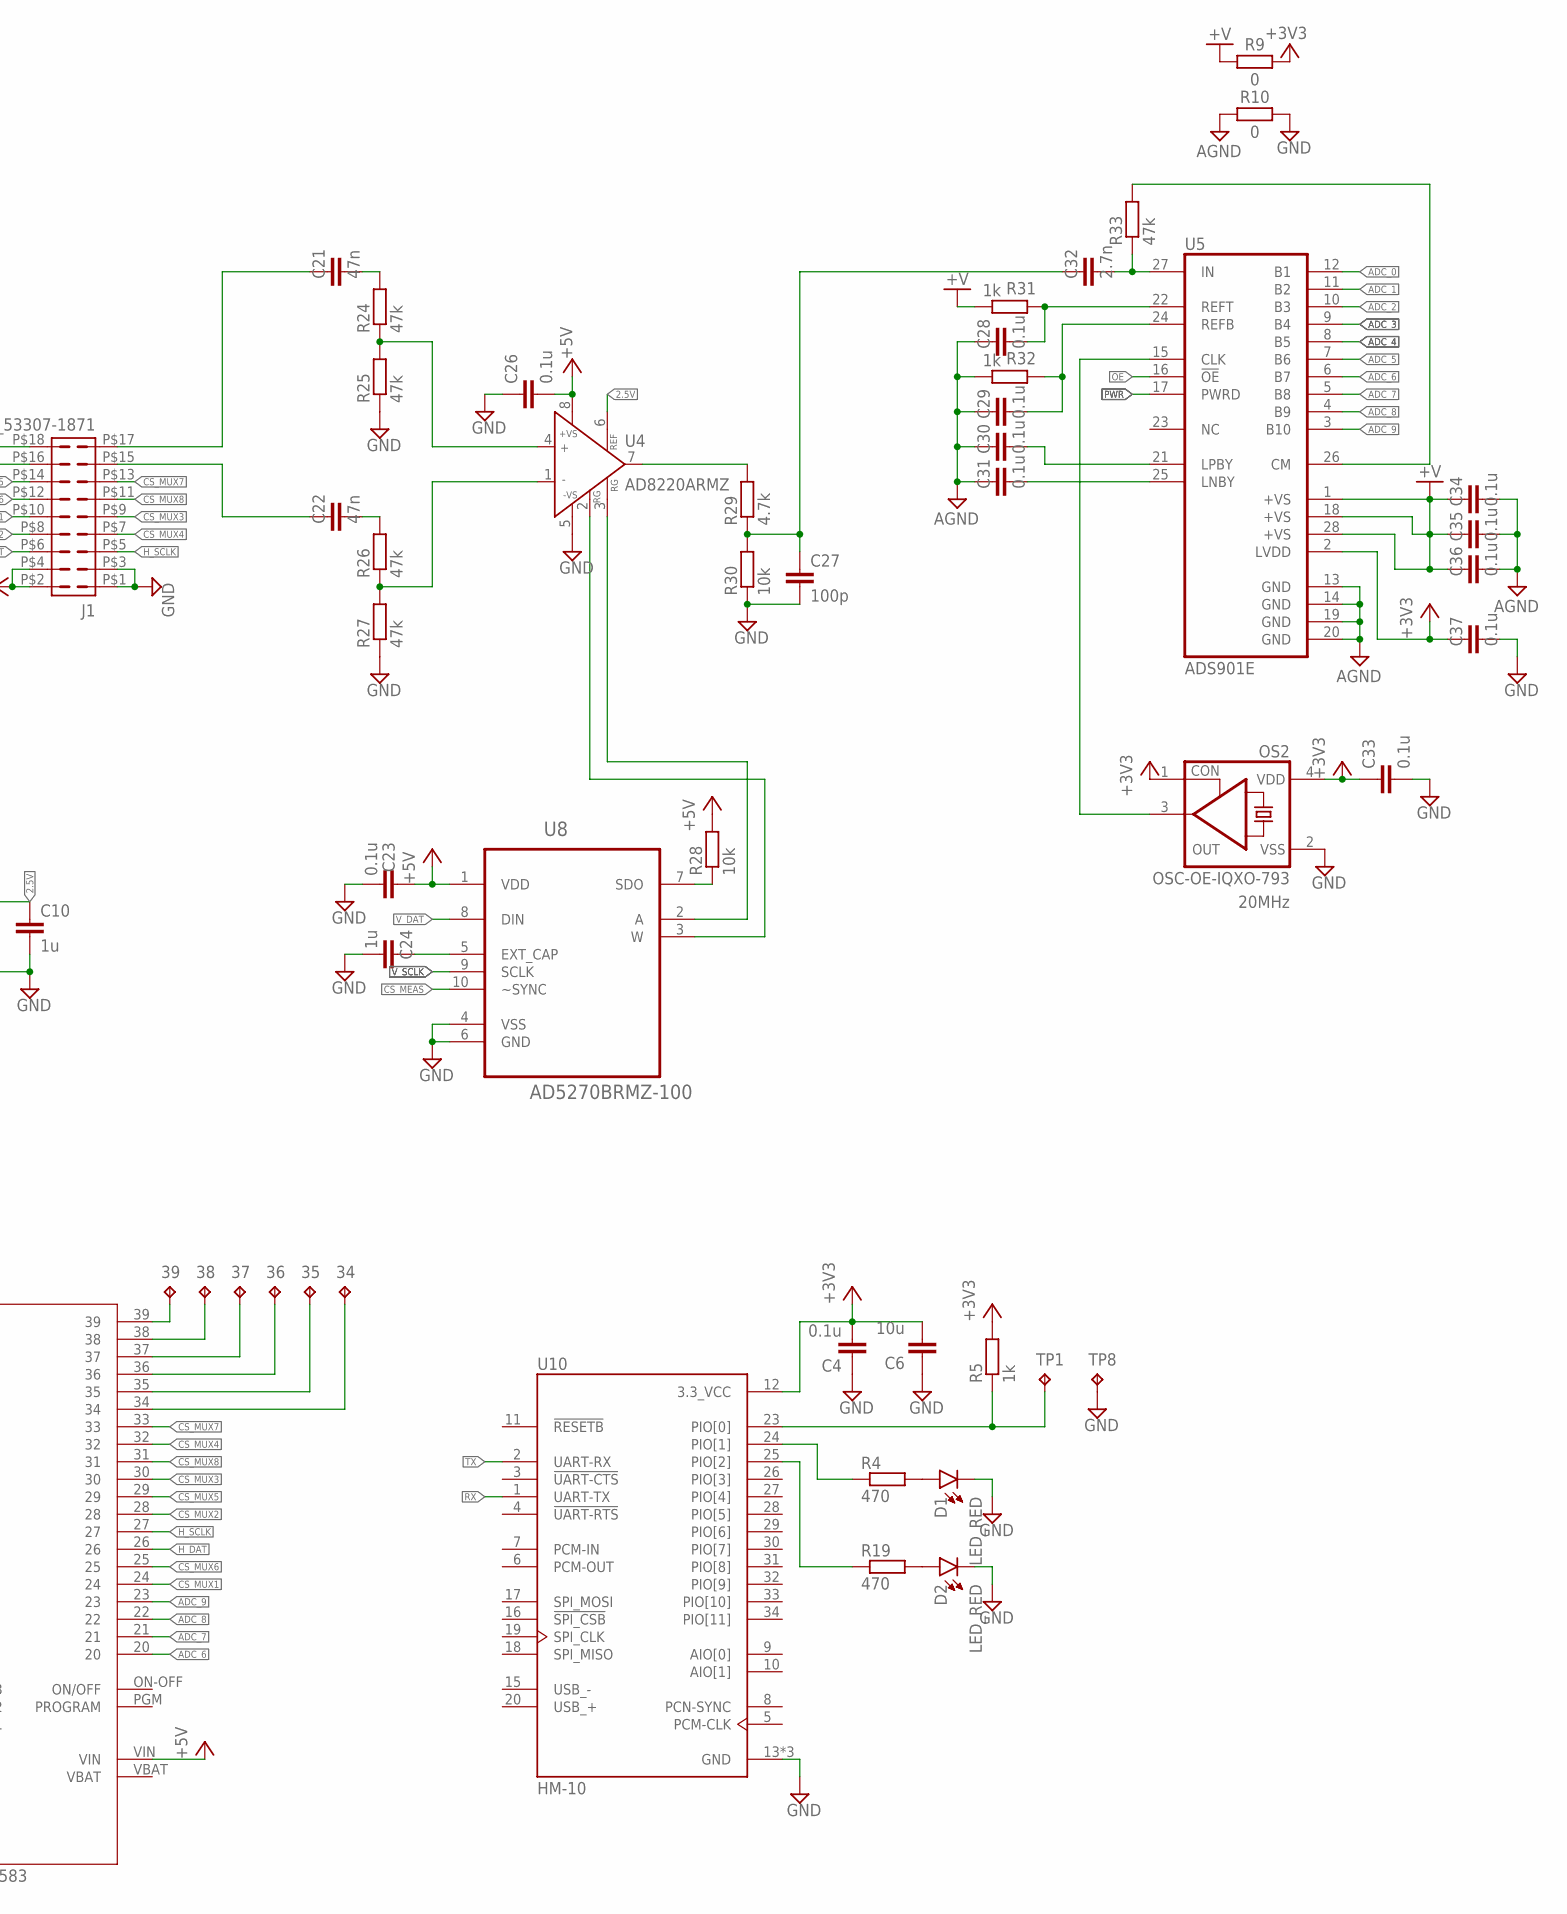
[picture p21: schematic Schematic.sch, part in row 1, column 2]

Parts:
34, 35, 36, 37, 38, 39: TPTP13R; TP13R
C1, C2, C4, C5, C7, C12, C14, C17, C23, C26: 0.1u; C0603
C3, C10, C13, C24: 1u; C0603
C6: 10u; CAPC2012X110
C8, C9: 10n; C0603
C21, C22: 47n; C0603
C27: 100p; C0603
C28, C29, C30, C31, C33, C34, C35, C36, C37: 0.1u; CAPC1005X60
C32: 2.7n; CAPC1005X60
C38, C39: 2.2u; C0603
D1, D2: LED_RED; LEDC1608X65N_RND-R
J1: MOLEX_53307-1871
OS1, OS2: OSC-OE-IQXO-793; 2.5X2-4-PAD
R1: 20k; R0603
R2, R3, R7, R8, R21, R22: 220; R0603
R4, R19: 470; R0603
R5: 1k; R0603
R6, R28, R30: 10k; R0603
R9, R10: 0; RESC1608X60
R11, R12, R13, R14, R15, R16, R17, R18, R24, R25, R26, R27: 47k; R0603
R29: 4.7k; R0603
R31, R32: 1k; RESC1005X40
R33: 47k; RESC1005X40
TP1, TP8: TPTP20SQ; TP20SQ
U1: AD5930; TSSOP20
U2, U4: AD8220ARMZ; MSOP8
U3: ADA4841-2YRMZ; MSOP8
U5: ADS901E; SSOP28BU
U6, U8: AD5270BRMZ-100; SOP50P490X110-10N
U7: TLV73325PDBVT; SOT95P280X145-5N
U9: DEV-15583; MODULE_DEV-15583
U10: HM-10

Connections:
2.5V: C10.1, R7.2, R14.1, U2.6 (REF), U4.6 (REF), U7.5 (OUT)
+3V3: C1.2, C4.2, C5.1, C6.2, C7.1, C33.1, C37.1, OS1.1 (CON), OS1.4 (VDD), OS2.1 (CON), OS2.4 (VDD), R5.2, R9.2, U1.4 (AVDD), U1.5 (DVDD), U5.2 (LVDD), U9.3.3V_1, U9.3.3V_2, U9.3.3V_3, U10.12 (3.3_VCC)
+5V: C3.2, C12.1, C14.2, C17.2, C23.1, C26.2, J1.P$2 (2), J1.P$4 (4), R6.2, R28.2, U2.8 (+VS), U3.8 (V+), U4.8 (+VS), U6.1 (VDD), U7.1 (IN), U7.3 (EN), U8.1 (VDD), U9.VIN
+V: C34.1, C35.1, C36.1, R9.1, R31.2, U5.1 (+VS), U5.18 (+VS), U5.28 (+VS)
ADC_0: U5.12 (B1), U9.14
ADC_1: U5.11 (B2), U9.15
ADC_2: U5.10 (B3), U9.16
ADC_3: U5.9 (B4), U9.17
ADC_4: U5.8 (B5), U9.18
ADC_5: U5.7 (B6), U9.19
ADC_6: U5.6 (B7), U9.20
ADC_7: U5.5 (B8), U9.21
ADC_8: U5.4 (B9), U9.22
ADC_9: U5.3 (B10), U9.23
AGND: C28.1, C29.1, C30.1, C31.1, C34.2, C35.2, C36.2, R10.1, R32.2, U5.13 (GND), U5.14 (GND), U5.19 (GND), U5.20 (GND)
CS_AD5930: U1.16 (FSYNC), U9.3
CS_DRIVE: U6.10 (~SYNC), U9.0
CS_MEAS: U8.10 (~SYNC), U9.1
CS_MUX1: J1.P$10 (10), U9.24
CS_MUX2: J1.P$8 (8), U9.28
CS_MUX3: J1.P$9 (9), U9.30
CS_MUX4: J1.P$7 (7), U9.32
CS_MUX5: J1.P$14 (14), U9.29
CS_MUX6: J1.P$12 (12), U9.25
CS_MUX7: J1.P$13 (13), U9.33
CS_MUX8: J1.P$11 (11), U9.31
CTRL: U1.13 (CTRL), U9.4
GND: C1.1, C2.1, C3.1, C4.1, C5.2, C6.1, C7.2, C8.2, C9.2, C10.2, C12.2, C13.2, C14.1, C17.1, C23.2, C24.2, C26.1, C27.2, C33.2, C37.2, D1.C, D2.C, J1.P$1 (1), J1.P$3 (3), OS1.2 (VSS), OS2.2 (VSS), R1.2, R2.2, R3.2, R10.2, R25.1, R27.1, R30.1, TP8.TP, U1.7 (DGND), U1.11 (DGNDOP), U1.18 (AGND), U2.5 (-VS), U3.4 (V-), U4.5 (-VS), U6.4 (VSS), U6.6 (GND), U7.2 (GND), U8.4 (VSS), U8.6 (GND), U9.G_1, U9.G_2, U9.G_3, U9.G_4, U9.G_5, U9.G_6, U10.13 (GND), U10.21 (GND), U10.22 (GND)
H_DAT: J1.P$6 (6), U9.26
H_SCLK: J1.P$5 (5), U9.27
INT: U1.12 (INTERRUPT), U9.5
MSB: U1.10 (MSBOUT), U9.6
unnamed: R1.1, U1.1 (FS_ADJUST)
unnamed: C8.1, U1.2 (REF)
unnamed: C9.1, U1.3 (COMP)
unnamed: R2.1, U1.20 (IOUTB), U2.1 (IN-)
unnamed: R3.1, U1.19 (IOUT), U2.4 (IN+)
unnamed: R7.1, R11.1
unnamed: R8.1, R13.1
unnamed: R14.2, R18.2, U3.6 (IN-)
unnamed: R13.2, R17.1, U3.5 (IN+)
unnamed: R11.2, R15.1, U3.3 (IN+)
unnamed: R12.2, R16.2, U3.2 (IN-)
unnamed: R16.1, R21.2, U3.1 (OUT)
unnamed: OS1.3 (OUT), U1.8 (MCLK)
unnamed: C2.2, U1.6 (CAP/2,5V)
unnamed: R18.1, R22.2, U3.7 (OUT)
unnamed: R6.1, U6.7 (SDO)
unnamed: C22.1, J1.P$15 (15)
unnamed: C21.1, J1.P$17 (17)
unnamed: U2.2 (RG), U6.3 (W)
unnamed: R8.2, R12.1, U2.7 (OUT)
unnamed: U2.3 (RG), U6.2 (A)
unnamed: C13.1, U6.5 (EXT_CAP)
unnamed: R28.1, U8.7 (SDO)
unnamed: R33.2, U5.26 (CM)
unnamed: C32.2, R33.1, U5.27 (IN)
unnamed: C24.1, U8.5 (EXT_CAP)
unnamed: C28.2, R31.1, U5.22 (REFT)
unnamed: C29.2, R32.1, U5.24 (REFB)
unnamed: C31.2, U5.25 (LNBY)
unnamed: C30.2, U5.21 (LPBY)
unnamed: U4.2 (RG), U8.3 (W)
unnamed: OS2.3 (OUT), U5.15 (CLK)
unnamed: R29.2, U4.7 (OUT)
unnamed: C21.2, R24.2
unnamed: R24.1, R25.2, U4.4 (IN+)
unnamed: R26.1, R27.2, U4.1 (IN-)
unnamed: C22.2, R26.2
unnamed: C38.2, J1.P$18 (18), R15.2
unnamed: U4.3 (RG), U8.2 (A)
unnamed: C27.1, C32.1, R29.1, R30.2
unnamed: D1.A, R4.2
unnamed: R5.1, TP1.TP, U10.23 (PIO[0])
unnamed: R4.1, U10.24 (PIO[1])
unnamed: D2.A, R19.2
unnamed: R19.1, U10.25 (PIO[2])
unnamed: 39.TP, U9.39
unnamed: 38.TP, U9.38
unnamed: 37.TP, U9.37
unnamed: 36.TP, U9.36
unnamed: 35.TP, U9.35
unnamed: 34.TP, U9.34
unnamed: C39.2, J1.P$16 (16), R17.2
unnamed: C38.1, R21.1
unnamed: C39.1, R22.1
OE: U5.16 (!OE), U9.10
PWR: U5.17 (PWRD), U9.9
RX: U9.7, U10.1 (UART-TX)
STBY: U1.17 (STANDBY), U9.2
TX: U9.8, U10.2 (UART-RX)
VBAT: U9.VBAT
V_DAT: U1.14 (SDATA), U6.8 (DIN), U8.8 (DIN), U9.11
V_SCLK: U1.15 (SCLK), U6.9 (SCLK), U8.9 (SCLK), U9.13

Notes on the sheet:
50MHz
20MHz

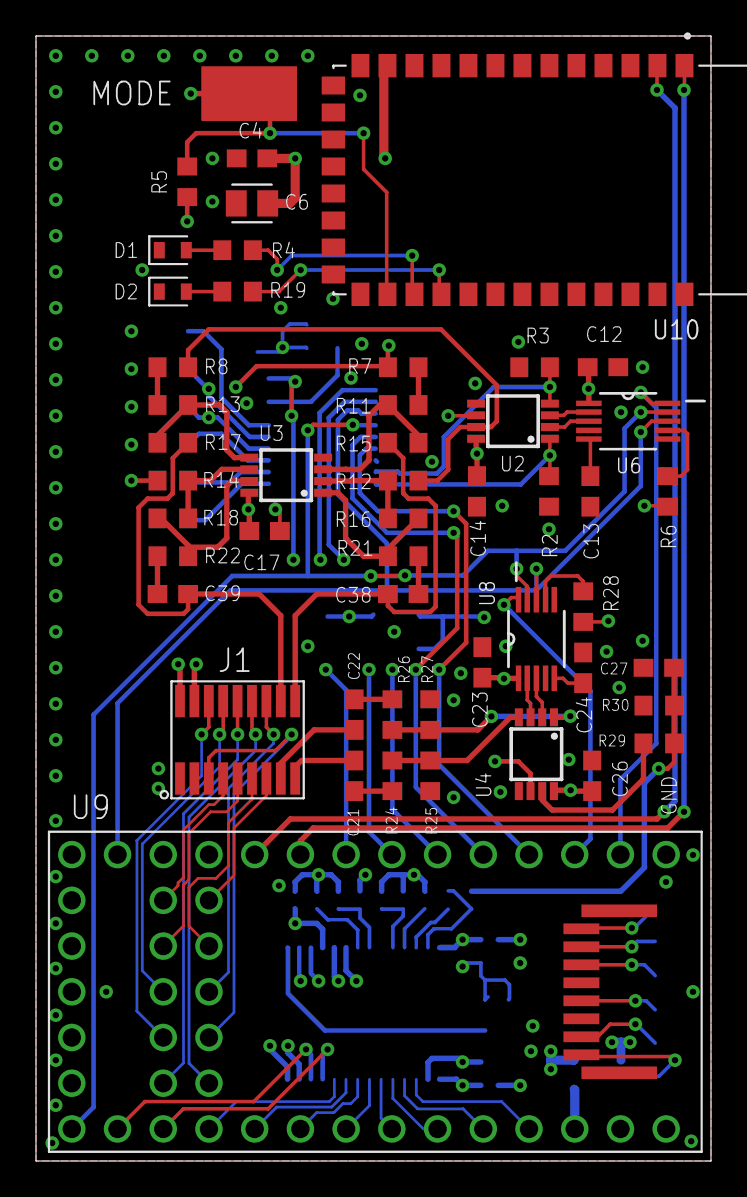
[picture p22: board EIT-kit-Board_new/Teensy_EIT_board-files/Main/PCB.brd from above]

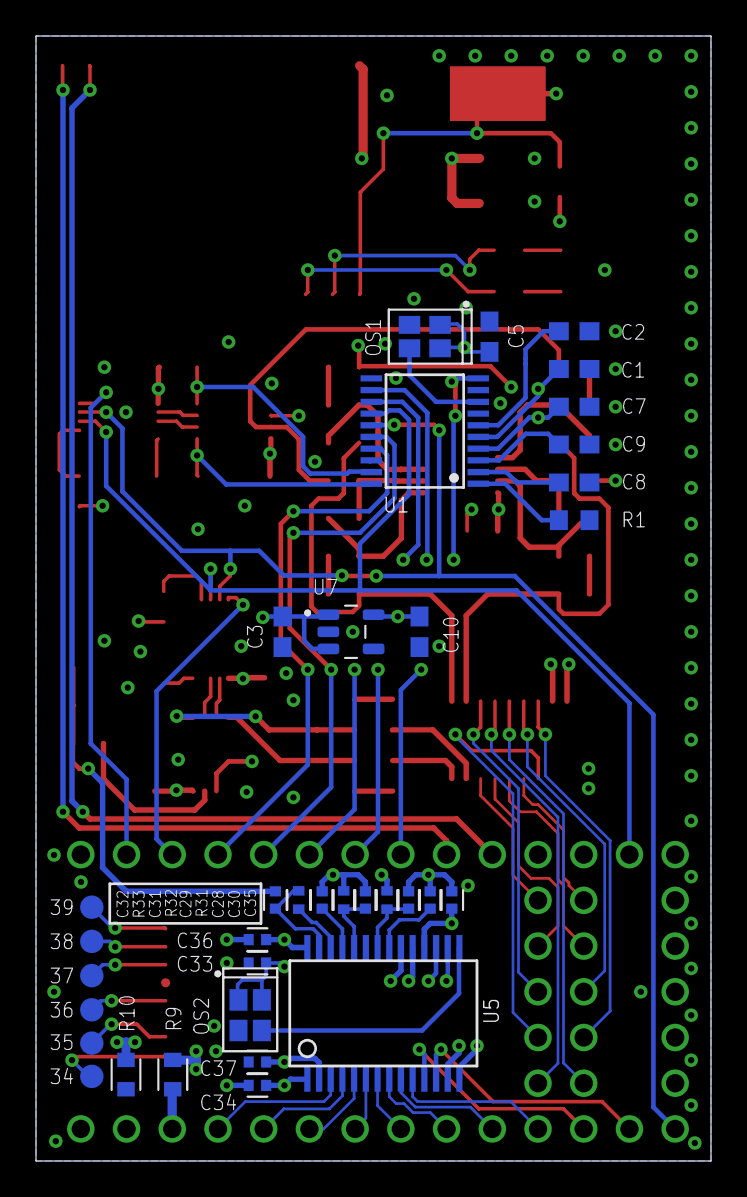
[picture p23: board EIT-kit-Board_new/Teensy_EIT_board-files/Main/PCB.brd from below]

Board: 4 copper layers, 37.5 x 62.5 mm, 86 parts (35 on the bottom side), 93 nets.
