HCIELab/EIT-kit_open-source/EIT-kit-Arduino-library/MCP23S17-modified-for-eit-kit/examples/Expander32/EchoInput/EchoInput.ino

#include <MCP23S17.h>

#ifdef __PIC32MX__
// chipKIT uses the DSPI library instead of the SPI library as it's better
#include <DSPI.h>
DSPI0 SPI;
#else
// Everytying else uses the SPI library
#include <SPI.h>
#endif

const uint8_t chipSelect = 10;

// Create an object for each chip
// Bank 0 is address 0
// Bank 1 is address 1.
// Increase the addresses by 2 for each BA value.

MCP23S17 Bank1(&SPI, chipSelect, 0);
MCP23S17 Bank2(&SPI, chipSelect, 1);

void setup() {
	Bank1.begin();
	Bank2.begin();

	Bank1.pinMode(15, OUTPUT);
	Bank2.pinMode(15, INPUT_PULLUP);
}

void loop() {
	Bank1.digitalWrite(15, !Bank2.digitalRead(15));
}
