HCIELab/EIT-kit_open-source/(commit log)

2021-10-15 update EIT-kit board files and arduino library
    [ESP32_EIT_BOM.csv, PnP_ESP32_EIT_back.csv, PnP_ESP32_EIT_front.csv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]
2021-10-15 add EAGLE version of the EIT-kit board as well
    [ESP32_EIT_V3.brd, ESP32_EIT_V3.sch]
2022-06-06 update bom files for mux1 & mux2
    [bom_main.csv, bom_mux_lower.csv, bom_mux_upper.csv]
2022-09-01 upload new EIT sensing board design
    [MUX1_BOM.csv, MUX2_BOM.csv, PCB.brd, PCB_BOM.csv, PnP_MUX1_back.csv, PnP_MUX1_front.csv, PnP_MUX2_back.csv, PnP_MUX2_front.csv]
2023-05-01 upload an example arduino file for EIT-kit Arduino library
